kyorin-phys/water-droplet/README.md

# Automated water droplet photography

## Introduction

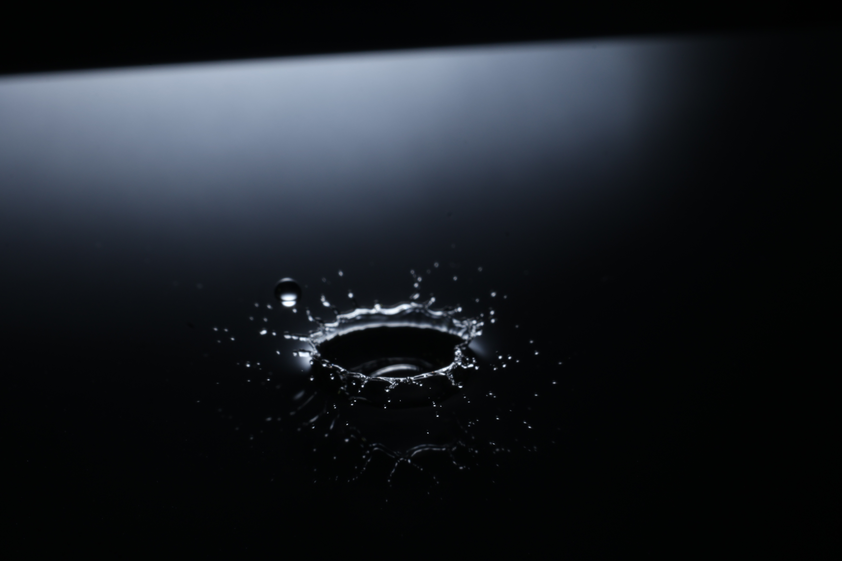
[picture p1: fig/IMG_6408.JPG]
splash photo


## Features

By using a microcontroller (e.g,. Arduino / Raspberry Pi Pico) to synchronize the solenoid valve, camera shuttter, and flush firing with millisecond accuracy.

## Camera

[camera](camera.md)

## Hardware

[hardware](hardware.md)

## Code

* [arduino](arduino/main.ino)
* [raspberry pi pico](pico/main.py)

## Usage
